tkreis/keyboard-tray/renders/flush_closeup.png

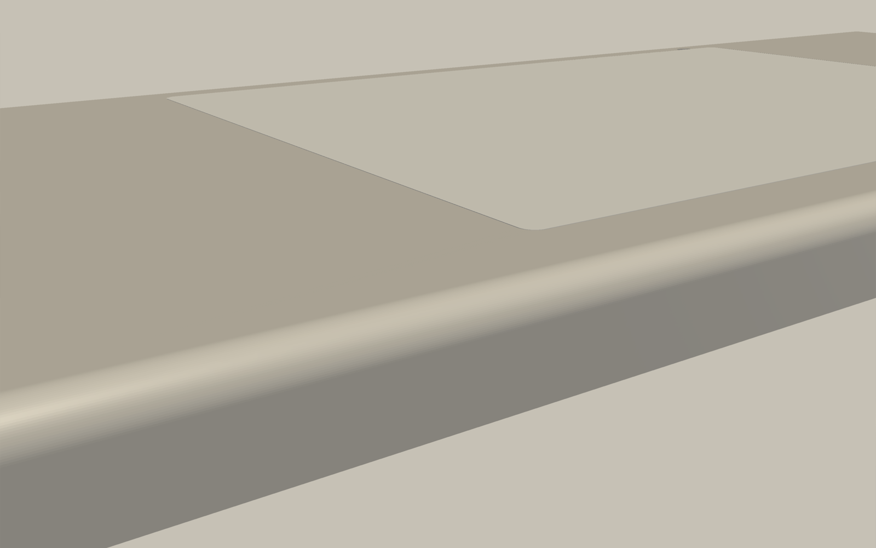
renders/flush_closeup.png
