tkreis/keyboard-tray/renders/rest.png

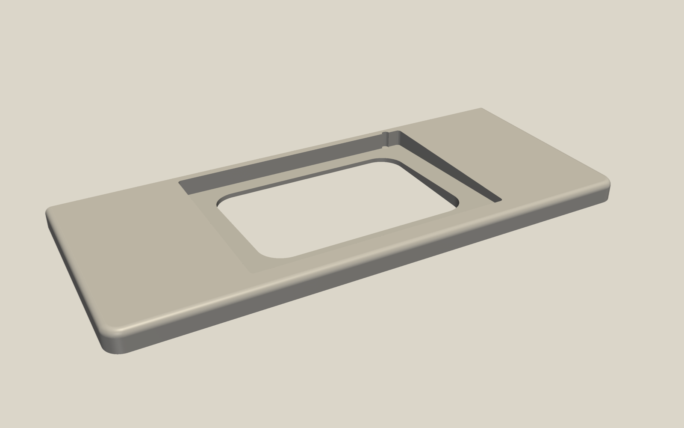
renders/rest.png
