tkreis/keyboard-tray/out/handrest_full.3mf

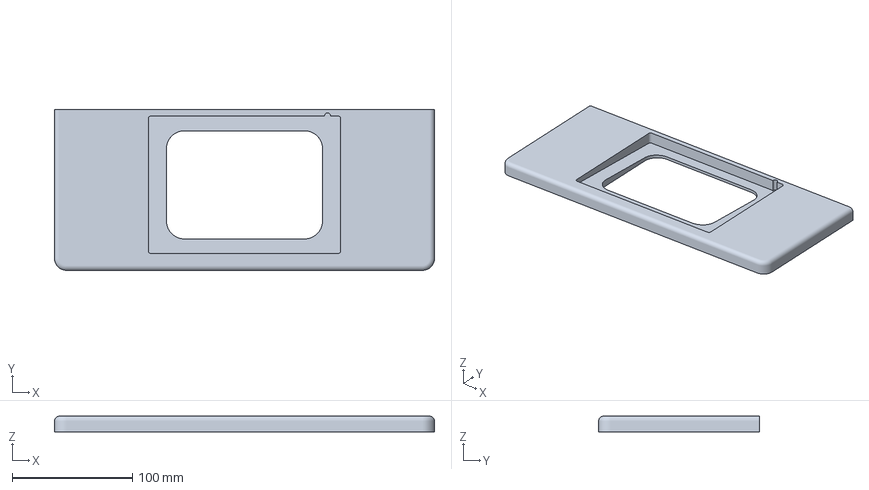
[picture p6: CAD file, 2026-10-18]
out/handrest_full.3mf
316.4 x 133.8 x 13.0 mm
