tkreis/keyboard-tray/out/handrest_wings.3mf

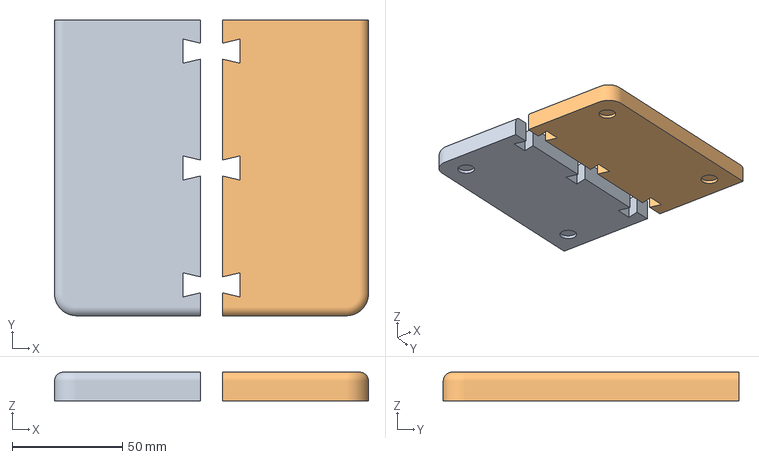
[picture p7: CAD file, 2026-10-18]
out/handrest_wings.3mf
142.2 x 133.8 x 13.0 mm
