tkreis/keyboard-tray/out/handrest_wing_right.3mf

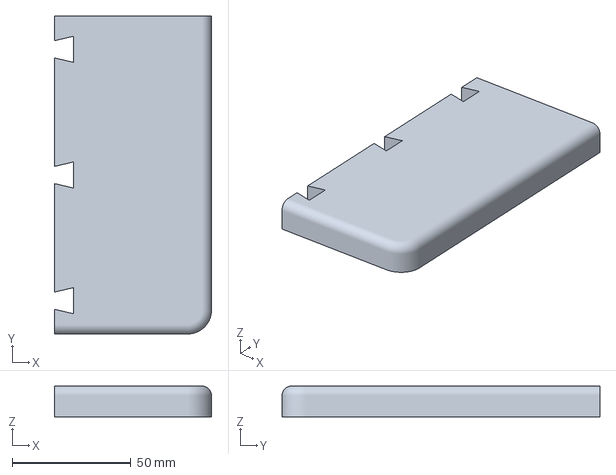
[picture p8: CAD file, 2026-10-18]
out/handrest_wing_right.3mf
66.1 x 133.8 x 13.0 mm
