tkreis/keyboard-tray/out/handrest_centre.3mf

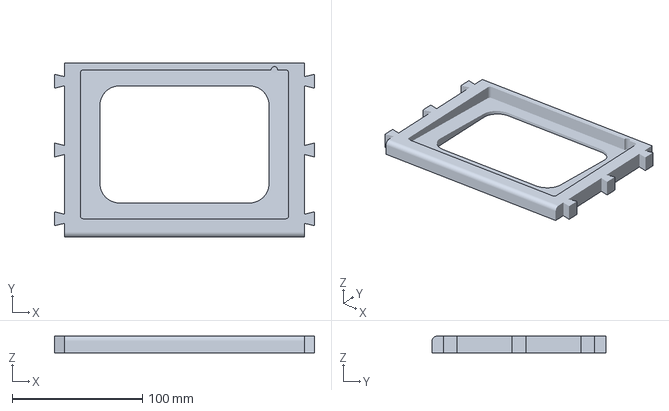
[picture p9: CAD file, 2026-10-18]
out/handrest_centre.3mf
199.9 x 133.8 x 13.0 mm
