tkreis/keyboard-tray/(list of files, cad)

Other CAD files:
out/handrest_wing_left.3mf
out/handrest_centre.stl
out/handrest_full.stl
out/handrest_wing_left.stl
out/handrest_wing_right.stl
