tkreis/keyboard-tray/(commit log)

2026-10-15 add printable handrest model
    [handrest_full.3mf, handrest_full.stl, handrest_left.3mf, handrest_left.stl, handrest_right.3mf, handrest_right.stl]
2026-10-15 split rest into centre and wings so seams avoid the pocket floor
    [handrest_centre.3mf, handrest_centre.stl, handrest_full.3mf, handrest_full.stl, handrest_left.3mf, handrest_left.stl, handrest_right.3mf, handrest_right.stl]
2026-10-15 move front dovetail back and keep bumpons protruding
    [handrest_centre.3mf, handrest_centre.stl, handrest_full.3mf, handrest_full.stl, handrest_wing_left.3mf, handrest_wing_left.stl, handrest_wing_right.3mf, handrest_wing_right.stl]
2026-10-16 match pocket corners to the 9 mm radius of current trackpads
    [handrest_centre.3mf, handrest_centre.stl, handrest_full.3mf, handrest_full.stl, handrest_wing_left.3mf, handrest_wing_right.3mf, handrest_wings.3mf]
2026-10-16 copy pocket fit from a fit-tested tray
    [handrest_centre.3mf, handrest_centre.stl, handrest_full.3mf, handrest_full.stl, handrest_wing_left.3mf, handrest_wing_left.stl, handrest_wing_right.3mf, handrest_wing_right.stl]
2026-10-16 update readme sizes for the new pocket fit
    [handrest_centre.3mf, handrest_full.3mf, handrest_wing_left.3mf, handrest_wing_right.3mf, handrest_wings.3mf]
2026-10-16 rebuild centre as a flat-top trackpad cage like the reference tray
    [handrest_centre.3mf, handrest_centre.stl, handrest_full.3mf, handrest_full.stl, handrest_wing_left.3mf, handrest_wing_left.stl, handrest_wing_right.3mf, handrest_wing_right.stl]
2026-10-16 match reference pocket depth, back wall and switch notch
    [handrest_centre.3mf, handrest_centre.stl, handrest_full.3mf, handrest_full.stl, handrest_wing_left.3mf, handrest_wing_left.stl, handrest_wing_right.3mf, handrest_wing_right.stl]
2026-10-16 keep switch notch out of the floor and check floor under the slots
    [handrest_centre.3mf, handrest_centre.stl, handrest_full.3mf, handrest_full.stl, handrest_wing_left.3mf, handrest_wing_right.3mf, handrest_wings.3mf]
2026-10-16 match reference floor cutout and switch notch exactly
    [handrest_centre.3mf, handrest_centre.stl, handrest_full.3mf, handrest_full.stl, handrest_wing_left.3mf, handrest_wing_right.3mf, handrest_wings.3mf]
2026-10-16 document switch notch depth and check its position
    [handrest_centre.3mf, handrest_full.3mf, handrest_wing_left.3mf, handrest_wing_right.3mf, handrest_wings.3mf]
2026-10-16 guard switch notch check against stray edges
2026-10-18 size pocket corners and cable slot for the 2015 lightning trackpad
    [handrest_centre.3mf, handrest_centre.stl, handrest_full.3mf, handrest_full.stl, handrest_wing_left.3mf, handrest_wing_right.3mf, handrest_wings.3mf]
2026-10-18 copy pocket corner radius from the small-radius magic tray
    [handrest_centre.3mf, handrest_centre.stl, handrest_full.3mf, handrest_full.stl, handrest_wing_left.3mf, handrest_wing_right.3mf, handrest_wings.3mf]
2026-10-18 clarify where the small pocket corner radius comes from
    [handrest_centre.3mf, handrest_full.3mf, handrest_wing_left.3mf, handrest_wing_right.3mf, handrest_wings.3mf]
2026-10-18 derive small pocket corner from the magic tray trackpad radius
    [handrest_centre.3mf, handrest_centre.stl, handrest_full.3mf, handrest_full.stl, handrest_wing_left.3mf, handrest_wing_right.3mf, handrest_wings.3mf]
2026-10-18 remove the cable slot from the back wall
    [handrest_centre.3mf, handrest_centre.stl, handrest_full.3mf, handrest_full.stl, handrest_wing_left.3mf, handrest_wing_left.stl, handrest_wing_right.3mf, handrest_wings.3mf]
